captaindpt/torch2rtl/docs/scalar_reports/summary.txt

module=gpu_top_scalar
status=FAILED
run_dir=../eda-pilot/runs/digital-flow/20260312_102733_gpu_top_scalar
rtl=./rtl/gpu_top_scalar.v
sdc=./constraints/gpu_top_scalar.sdc
synth_tool=genus
dc_synth_lib=/CMC/kits/cadence/GPDK045/gsclib045_all_v4.4/gsclib045/timing/slow_vdd1v0_basicCells.lib
timing_lib=/CMC/kits/cadence/GPDK045/gsclib045_all_v4.4/gsclib045/timing/slow_vdd1v0_basicCells.lib
pt_requested_lib=/CMC/kits/cadence/GPDK045/gsclib045_all_v4.4/gsclib045/timing/slow_vdd1v0_basicCells.lib
pt_target_lib=../eda-pilot/runs/digital-flow/libcache/slow_vdd1v0_basicCells_ptsafe.lib
pt_sdc=../eda-pilot/runs/digital-flow/20260312_102733_gpu_top_scalar/primetime/gpu_top_scalar_pt.sdc
activity_vcd=../eda-pilot/runs/digital-flow/20260312_102733_gpu_top_scalar/rtl-sim/gpu_top_scalar_activity.vcd
activity_vcd_scope=tb_gpu_inference_scalar.dut
activity_hinst=
quantus_corner=typical
quantus_spef=../eda-pilot/runs/digital-flow/20260312_102733_gpu_top_scalar/innovus/out/gpu_top_scalar.spef
tb=./tb/tb_gpu_inference_scalar.v
dc_mapped=../eda-pilot/runs/digital-flow/20260312_102733_gpu_top_scalar/dc/out/gpu_top_scalar_mapped.v
innovus_def=../eda-pilot/runs/digital-flow/20260312_102733_gpu_top_scalar/innovus/out/gpu_top_scalar.def
innovus_postroute=../eda-pilot/runs/digital-flow/20260312_102733_gpu_top_scalar/innovus/out/gpu_top_scalar_postroute.v
innovus_gds=../eda-pilot/runs/digital-flow/20260312_102733_gpu_top_scalar/innovus/out/gpu_top_scalar.gds
innovus_spef=../eda-pilot/runs/digital-flow/20260312_102733_gpu_top_scalar/innovus/out/gpu_top_scalar.spef
primetime_setup=../eda-pilot/runs/digital-flow/20260312_102733_gpu_top_scalar/primetime/reports/gpu_top_scalar_setup.rpt
primetime_hold=../eda-pilot/runs/digital-flow/20260312_102733_gpu_top_scalar/primetime/reports/gpu_top_scalar_hold.rpt
primetime_constraints=../eda-pilot/runs/digital-flow/20260312_102733_gpu_top_scalar/primetime/reports/gpu_top_scalar_constraints.rpt
pegasus_db=../eda-pilot/runs/digital-flow/20260312_102733_gpu_top_scalar/pegasus/gpu_top_scalar.db

stage	status	detail
rtl_sim	PASS	log=../eda-pilot/runs/digital-flow/20260312_102733_gpu_top_scalar/rtl-sim/xrun.log
synth	PASS	tool=genus netlist=../eda-pilot/runs/digital-flow/20260312_102733_gpu_top_scalar/dc/out/gpu_top_scalar_mapped.v
innovus	PASS	gds=../eda-pilot/runs/digital-flow/20260312_102733_gpu_top_scalar/innovus/out/gpu_top_scalar.gds
quantus	FAIL	log=../eda-pilot/runs/digital-flow/20260312_102733_gpu_top_scalar/quantus/quantus.stdout.log fallback_spef=../eda-pilot/runs/digital-flow/20260312_102733_gpu_top_scalar/innovus/out/gpu_top_scalar.spef
primetime	PASS	setup=../eda-pilot/runs/digital-flow/20260312_102733_gpu_top_scalar/primetime/reports/gpu_top_scalar_setup.rpt lib=../eda-pilot/runs/digital-flow/libcache/slow_vdd1v0_basicCells_ptsafe.lib
pegasus	FAIL	violations_found log=../eda-pilot/runs/digital-flow/20260312_102733_gpu_top_scalar/pegasus/gpu_top_scalar_drc.log
