captaindpt/torch2rtl/docs/vector_reports/summary.txt

module=gpu_top
status=FAILED
run_dir=../eda-pilot/runs/digital-flow/20260312_100917_gpu_top
rtl=./rtl/gpu_top.v
sdc=./constraints/gpu_top.sdc
synth_tool=genus
dc_synth_lib=/CMC/kits/cadence/GPDK045/gsclib045_all_v4.4/gsclib045/timing/slow_vdd1v0_basicCells.lib
timing_lib=/CMC/kits/cadence/GPDK045/gsclib045_all_v4.4/gsclib045/timing/slow_vdd1v0_basicCells.lib
pt_requested_lib=/CMC/kits/cadence/GPDK045/gsclib045_all_v4.4/gsclib045/timing/slow_vdd1v0_basicCells.lib
pt_target_lib=../eda-pilot/runs/digital-flow/libcache/slow_vdd1v0_basicCells_ptsafe.lib
pt_sdc=../eda-pilot/runs/digital-flow/20260312_100917_gpu_top/primetime/gpu_top_pt.sdc
activity_vcd=../eda-pilot/runs/digital-flow/20260312_100917_gpu_top/rtl-sim/gpu_top_activity.vcd
activity_vcd_scope=tb_gpu_inference.dut
activity_hinst=
quantus_corner=typical
quantus_spef=../eda-pilot/runs/digital-flow/20260312_100917_gpu_top/innovus/out/gpu_top.spef
tb=./tb/tb_gpu_inference.v
dc_mapped=../eda-pilot/runs/digital-flow/20260312_100917_gpu_top/dc/out/gpu_top_mapped.v
innovus_def=../eda-pilot/runs/digital-flow/20260312_100917_gpu_top/innovus/out/gpu_top.def
innovus_postroute=../eda-pilot/runs/digital-flow/20260312_100917_gpu_top/innovus/out/gpu_top_postroute.v
innovus_gds=../eda-pilot/runs/digital-flow/20260312_100917_gpu_top/innovus/out/gpu_top.gds
innovus_spef=../eda-pilot/runs/digital-flow/20260312_100917_gpu_top/innovus/out/gpu_top.spef
primetime_setup=../eda-pilot/runs/digital-flow/20260312_100917_gpu_top/primetime/reports/gpu_top_setup.rpt
primetime_hold=../eda-pilot/runs/digital-flow/20260312_100917_gpu_top/primetime/reports/gpu_top_hold.rpt
primetime_constraints=../eda-pilot/runs/digital-flow/20260312_100917_gpu_top/primetime/reports/gpu_top_constraints.rpt
pegasus_db=../eda-pilot/runs/digital-flow/20260312_100917_gpu_top/pegasus/gpu_top.db

stage	status	detail
rtl_sim	PASS	log=../eda-pilot/runs/digital-flow/20260312_100917_gpu_top/rtl-sim/xrun.log
synth	PASS	tool=genus netlist=../eda-pilot/runs/digital-flow/20260312_100917_gpu_top/dc/out/gpu_top_mapped.v
innovus	PASS	gds=../eda-pilot/runs/digital-flow/20260312_100917_gpu_top/innovus/out/gpu_top.gds
quantus	FAIL	log=../eda-pilot/runs/digital-flow/20260312_100917_gpu_top/quantus/quantus.stdout.log fallback_spef=../eda-pilot/runs/digital-flow/20260312_100917_gpu_top/innovus/out/gpu_top.spef
primetime	PASS	setup=../eda-pilot/runs/digital-flow/20260312_100917_gpu_top/primetime/reports/gpu_top_setup.rpt lib=../eda-pilot/runs/digital-flow/libcache/slow_vdd1v0_basicCells_ptsafe.lib
pegasus	FAIL	violations_found log=../eda-pilot/runs/digital-flow/20260312_100917_gpu_top/pegasus/gpu_top_drc.log
