captaindpt/torch2rtl/(commit log)

2026-03-11 Link synthesis flow to eda-pilot
2026-03-11 Add measured scalar baseline comparison
    [scalar_comparison.csv]
2026-03-11 Refresh benchmark with measured SIMD rerun
    [scalar_comparison.csv]
2026-03-12 Harden benchmark with VCD power, CTS, extracted STA, and layout images
    - Power now uses VCD-annotated Genus reports from actual MLP inference
    switching activity instead of default toggle estimates
    - Backend flow adds CTS (ccopt_design) and routed SPEF for PrimeTime
    - PrimeTime runs with propagated clocks and extracted parasitics
    - Updated numbers: SIMD 0.71 mW / 86 MHz / 15.9 nJ,
    scalar 0.18 mW / 91 MHz / 8.2 nJ
    - Energy gap narrows from 3.7x to 1.93x with honest power
    - Added layout visualization images and pipeline/comparison charts
    - README now includes layout gallery and inline diagrams
    [model_shape_sweep.csv, scalar_comparison.csv]
2026-03-12 Fix stale glyph values in SVG charts
    The SVG comment text was updated but rendered glyph references still
    spelled old pre-CTS numbers. Fixed: scalar latency 34.31→45.38 μs,
    SIMD latency 16.31→22.47 μs, SIMD energy 10.17→15.90 nJ.
